Gemuesesaft/freEDrum/Electronics/HeadphoneOut.kicad_sch

## KiCad design Electronics/HeadphoneOut.kicad_sch (2024-04-20)

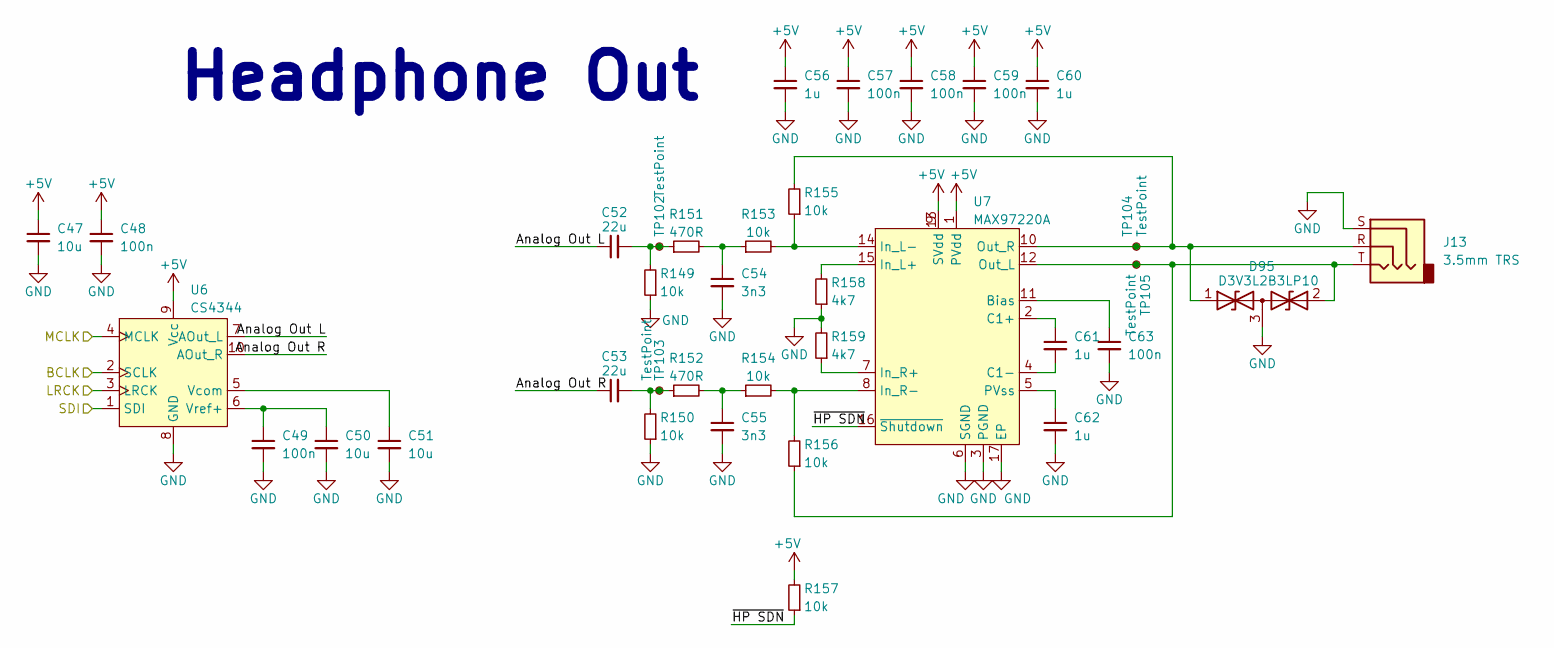
[picture p1: schematic HeadphoneOut.kicad_sch]

Parts:
C47, C50, C51: 10u; C_0805_2012Metric; Rated Voltage 25V; Tolerance 10%; Manufacturer Part # CL21A106KAYNNNE; JLCPCB Part # C15850
C48, C49, C57, C58, C59, C63: 100n; C_0402_1005Metric; Rated Voltage 50V; Tolerance 10%; Manufacturer Part # CL05B104KB54PNC; JLCPCB Part # C307331
C52, C53: 22u; C_1206_3216Metric; Rated Voltage 25V; Tolerance 10%; Manufacturer Part # CL31A226KAHNNNE; JLCPCB Part # C12891
C54, C55: 3n3; C_0603_1608Metric; Rated Voltage 50V; Tolerance 5%; Manufacturer Part # GRM1885C1H332JA01D; JLCPCB Part # C77036
C56, C60, C61, C62: 1u; C_0805_2012Metric; Rated Voltage 50V; Tolerance 10%; Manufacturer Part # CL21B105KBFNNNE; JLCPCB Part # C28323
D95: D3V3L2B3LP10; DFN-3 1010; Manufacturer Part # D3V3L2B3LP10-7; JLCPCB Part # C1974778
J13: 3.5mm TRS; PJ-320B; Manufacturer Part # PJ-320B; JLCPCB Part # C18594
R149, R150, R153, R154, R155, R156, R157: 10k; R_0402_1005Metric; Tolerance 1%; Manufacturer Part # 0402WGF1002TCE; JLCPCB Part # C25744
R151, R152: 470R; R_0402_1005Metric; Tolerance 1%; Manufacturer Part # 0402WGF4700TCE; JLCPCB Part # C25117
R158, R159: 4k7; R_0402_1005Metric; Tolerance 1%; Manufacturer Part # 0402WGF4701TCE; JLCPCB Part # C25900
TP102, TP103, TP104, TP105: TestPoint; TestPoint_Pad_D1.0mm
U6: CS4344; TSSOP-10_3x3mm_P0.5mm; Manufacturer Part # CS4344-CZZR; JLCPCB Part # C8952
U7: MAX97220A; QFN-16-1EP_3x3mm_P0.5mm_EP1.7x1.7mm_ThermalVias; Manufacturer Part # MAX97220AETE+T; JLCPCB Part # C2682711

Connections:
+5V: C47.1, C48.1, C56.1, C57.1, C58.1, C59.1, C60.1, R157.2, U6.9 (Vcc), U7.1 (PVdd), U7.9 (SVdd), U7.13 (SVdd)
Analog Out L: C52.1, U6.7 (AOut_L)
Analog Out R: C53.1, U6.10 (AOut_R)
BCLK: U6.2 (SCLK)
GND: C47.2, C48.2, C49.2, C50.2, C51.2, C54.2, C55.2, C56.2, C57.2, C58.2, C59.2, C60.2, C62.2, C63.2, D95.3 (common), J13.S, R149.1, R150.1, R158.1, R159.2, U6.8 (GND), U7.3 (PGND), U7.6 (SGND), U7.17 (EP)
LRCK: U6.3 (LRCK)
MCLK: U6.4 (MCLK)
unnamed: C49.1, C50.1, U6.6 (Vref+)
unnamed: C51.1, U6.5 (Vcom)
unnamed: C52.2, R149.2, R151.1, TP102.1
unnamed: C53.2, R150.2, R152.1, TP103.1
unnamed: C54.1, R151.2, R153.1
unnamed: C55.1, R152.2, R154.1
unnamed: C61.1, U7.2 (C1+)
unnamed: C61.2, U7.4 (C1-)
unnamed: C62.1, U7.5 (PVss)
unnamed: C63.1, U7.11 (Bias)
unnamed: D95.1 (A1), J13.R, R155.2, TP104.1, U7.10 (Out_R)
unnamed: D95.2 (A2), J13.T, R156.1, TP105.1, U7.12 (Out_L)
unnamed: R153.2, R155.1, U7.14 (In_L-)
unnamed: R154.2, R156.2, U7.8 (In_R-)
unnamed: R158.2, U7.15 (In_L+)
unnamed: R159.1, U7.7 (In_R+)
SDI: U6.1 (SDI)
~HP SDN: R157.1, U7.16 (~Shutdown)

Notes on the sheet:
Headphone Out
