Gemuesesaft/freEDrum/Electronics/Midi.kicad_sch

## KiCad design Electronics/Midi.kicad_sch (2024-04-20)

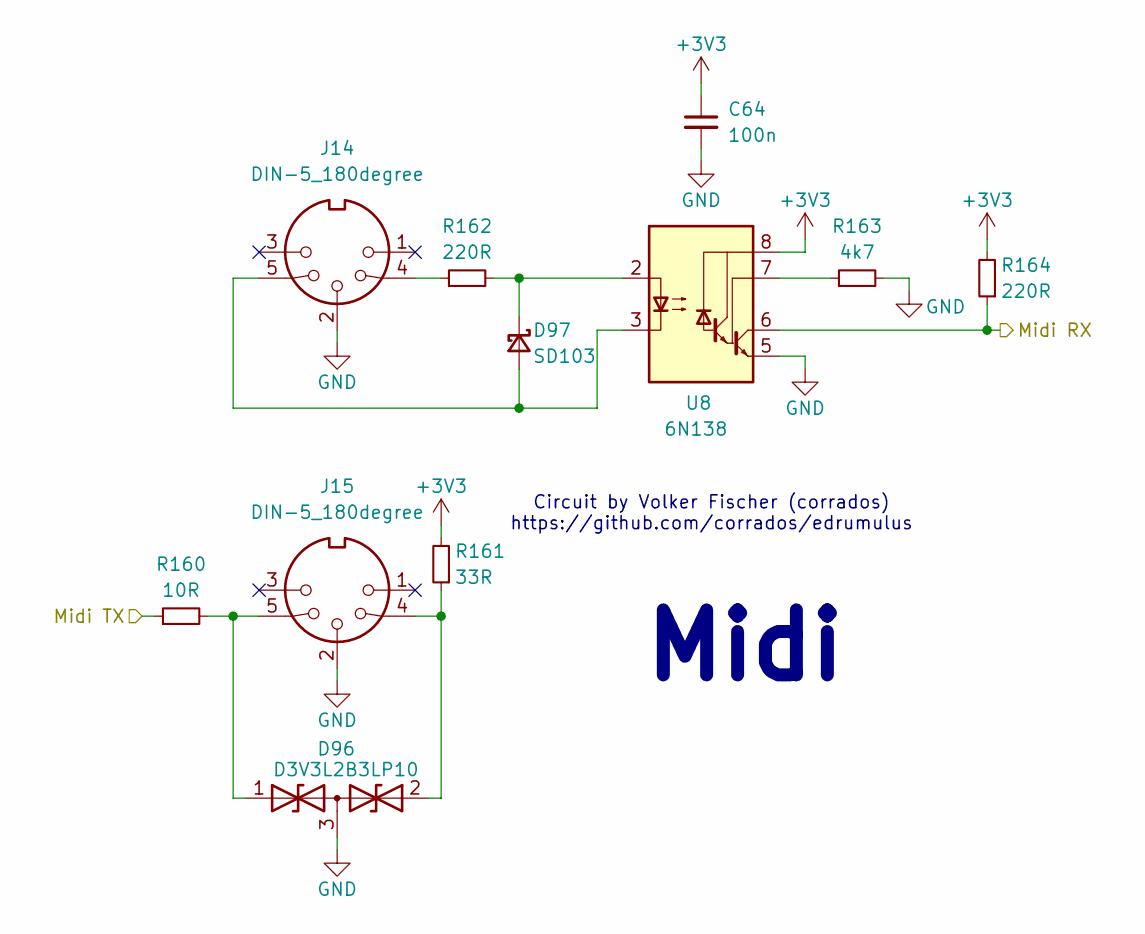
[picture p2: schematic Midi.kicad_sch]

Parts:
C64: 100n; C_0402_1005Metric; Rated Voltage 50V; Tolerance 10%; Manufacturer Part # CL05B104KB54PNC; JLCPCB Part # C307331
D96: D3V3L2B3LP10; DFN-3 1010; Manufacturer Part # D3V3L2B3LP10-7; JLCPCB Part # C1974778
D97: SD103; D_SOD-323; Manufacturer Part # SD103AWS; JLCPCB Part # C7420360
J14, J15: DIN-5_180degree; DIN-504D-M5; Manufacturer Part # DIN-504D-M5; JLCPCB Part # C2939347
R160: 10R; R_0402_1005Metric; Tolerance 1%; Manufacturer Part # 0402WGF100JTCE; JLCPCB Part # C25077
R161: 33R; R_0402_1005Metric; Tolerance 1%; Manufacturer Part # 0402WGF330JTCE; JLCPCB Part # C25105
R162, R164: 220R; R_0402_1005Metric; Tolerance 1%; Manufacturer Part # 0402WGF2200TCE; JLCPCB Part # C25091
R163: 4k7; R_0402_1005Metric; Tolerance 1%; Manufacturer Part # 0402WGF4701TCE; JLCPCB Part # C25900
U8: 6N138; SOP-8_6.605x9.655mm_P2.54mm; Manufacturer Part # 6N138SM; JLCPCB Part # C255744

Connections:
+3V3: C64.1, R161.2, R164.2, U8.8 (VCC)
GND: C64.2, D96.3 (common), J14.2, J15.2, R163.2, U8.5 (GND)
Midi RX: R164.1, U8.6 (VO2)
Midi TX: R160.1
unnamed: D96.1 (A1), J15.5, R160.2
unnamed: D96.2 (A2), J15.4, R161.1
unnamed: D97.1 (K), R162.2, U8.2 (C1)
unnamed: D97.2 (A), J14.5, U8.3 (C2)
unnamed: J14.4, R162.1
unnamed: R163.1, U8.7 (VO1)

Notes on the sheet:
Midi
Circuit by Volker Fischer (corrados) https://github.com/corrados/edrumulus
