Gemuesesaft/freEDrum/Electronics/PedalInput.kicad_sch

## KiCad design Electronics/PedalInput.kicad_sch (2024-04-20)

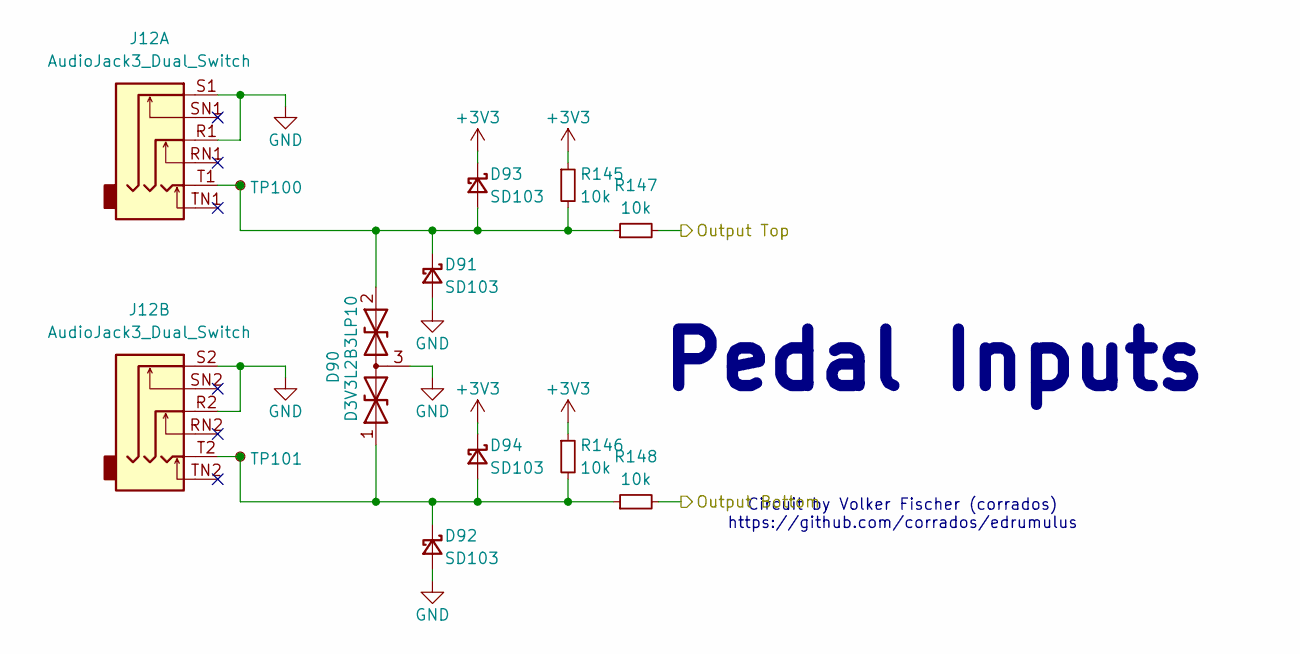
[picture p3: schematic PedalInput.kicad_sch]

Parts:
D90: D3V3L2B3LP10; DFN-3 1010; Manufacturer Part # D3V3L2B3LP10-7; JLCPCB Part # C1974778
D91, D92, D93, D94: SD103; D_SOD-323; Manufacturer Part # SD103AWS; JLCPCB Part # C7420360
J12: AudioJack3_Dual_Switch; PJ-625DK; Manufacturer Part # PJ-625DK; JLCPCB Part # C309295
R145, R146, R147, R148: 10k; R_0402_1005Metric; Tolerance 1%; Manufacturer Part # 0402WGF1002TCE; JLCPCB Part # C25744
TP100, TP101: TestPoint; TestPoint_Pad_D1.0mm

Connections:
+3V3: D93.1 (K), D94.1 (K), R145.1, R146.1
GND: D90.3 (common), D91.2 (A), D92.2 (A), J12.R1, J12.R2, J12.S1, J12.S2
unnamed: D90.1 (A1), D92.1 (K), D94.2 (A), J12.T2, R146.2, R148.1, TP101.1
unnamed: D90.2 (A2), D91.1 (K), D93.2 (A), J12.T1, R145.2, R147.1, TP100.1
Output Bottom: R148.2
Output Top: R147.2

Notes on the sheet:
Pedal Inputs
Circuit by Volker Fischer (corrados) https://github.com/corrados/edrumulus
