Gemuesesaft/freEDrum/Electronics/RS485Transceiver.kicad_sch

## KiCad design Electronics/RS485Transceiver.kicad_sch (2024-04-20)

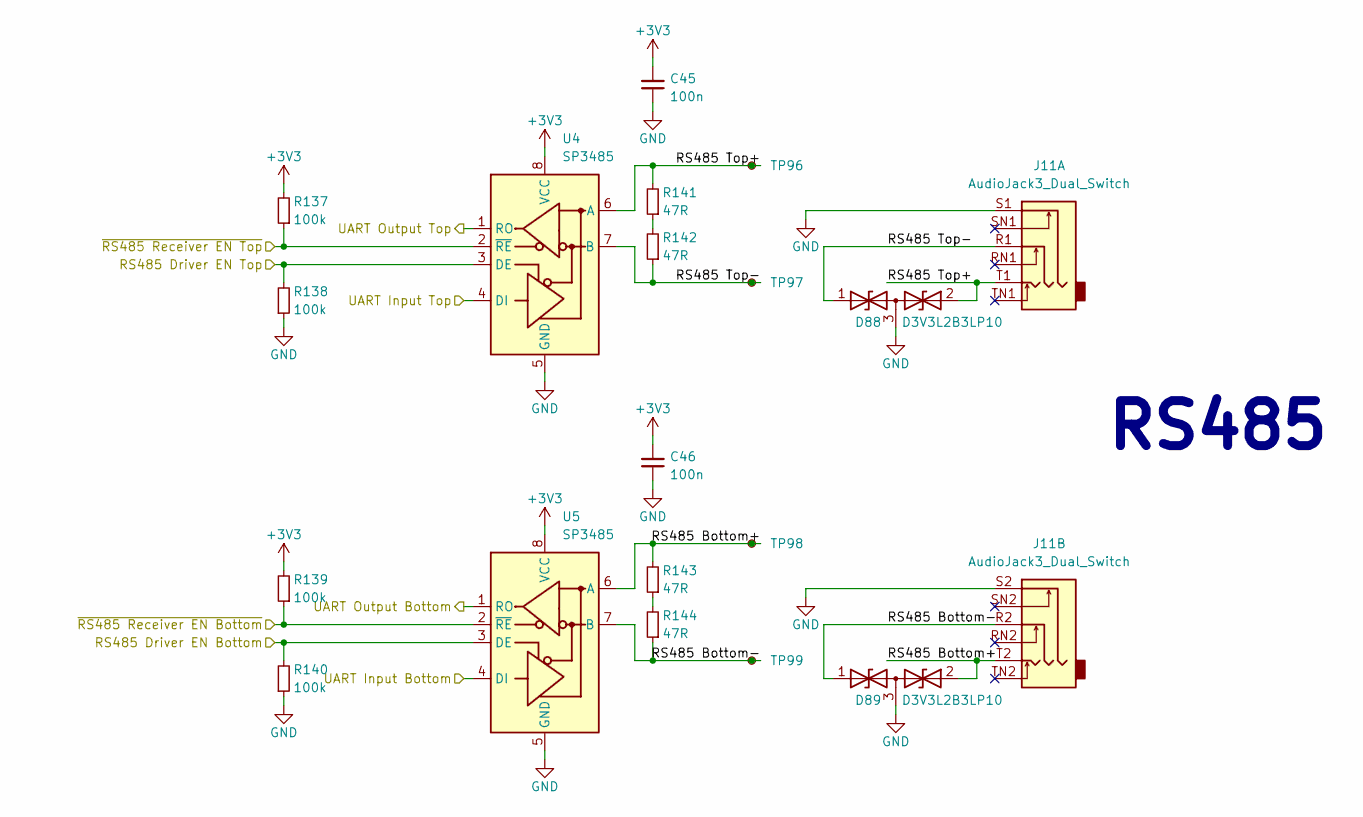
[picture p4: schematic RS485Transceiver.kicad_sch]

Parts:
C45, C46: 100n; C_0402_1005Metric; Rated Voltage 50V; Tolerance 10%; Manufacturer Part # CL05B104KB54PNC; JLCPCB Part # C307331
D88, D89: D3V3L2B3LP10; DFN-3 1010; Manufacturer Part # D3V3L2B3LP10-7; JLCPCB Part # C1974778
J11: AudioJack3_Dual_Switch; PJ-625DK; Manufacturer Part # PJ-625DK; JLCPCB Part # C309295
R137, R138, R139, R140: 100k; R_0402_1005Metric; Tolerance 1%; Manufacturer Part # 0402WGF1003TCE; JLCPCB Part # C25741
R141, R142, R143, R144: 47R; R_0805_2012Metric; Tolerance 1%; Manufacturer Part # 0805W8F470JT5E; JLCPCB Part # C17714
TP96, TP97, TP98, TP99: TestPoint; TestPoint_Pad_D1.0mm
U4, U5: SP3485; SOIC-8_3.9x4.9mm_P1.27mm; Manufacturer Part # SP3485EN-L/TR; JLCPCB Part # C8963

Connections:
+3V3: C45.2, C46.2, R137.2, R139.2, U4.8 (VCC), U5.8 (VCC)
GND: C45.1, C46.1, D88.3 (common), D89.3 (common), J11.S1, J11.S2, R138.1, R140.1, U4.5 (GND), U5.5 (GND)
unnamed: R141.1, R142.2
unnamed: R143.1, R144.2
RS485 Bottom+: D89.2 (A2), J11.T2, R143.2, TP98.1, U5.6 (A)
RS485 Bottom-: D89.1 (A1), J11.R2, R144.1, TP99.1, U5.7 (B)
RS485 Driver EN Bottom: R140.2, U5.3 (DE)
RS485 Driver EN Top: R138.2, U4.3 (DE)
RS485 Top+: D88.2 (A2), J11.T1, R141.2, TP96.1, U4.6 (A)
RS485 Top-: D88.1 (A1), J11.R1, R142.1, TP97.1, U4.7 (B)
UART Input Bottom: U5.4 (DI)
UART Input Top: U4.4 (DI)
UART Output Bottom: U5.1 (RO)
UART Output Top: U4.1 (RO)
~RS485 Receiver EN Bottom: R139.1, U5.2 (~RE)
~RS485 Receiver EN Top: R137.1, U4.2 (~RE)

Notes on the sheet:
RS485
