Gemuesesaft/freEDrum/Electronics/TriggerInput.kicad_sch

## KiCad design Electronics/TriggerInput.kicad_sch (2024-04-20)

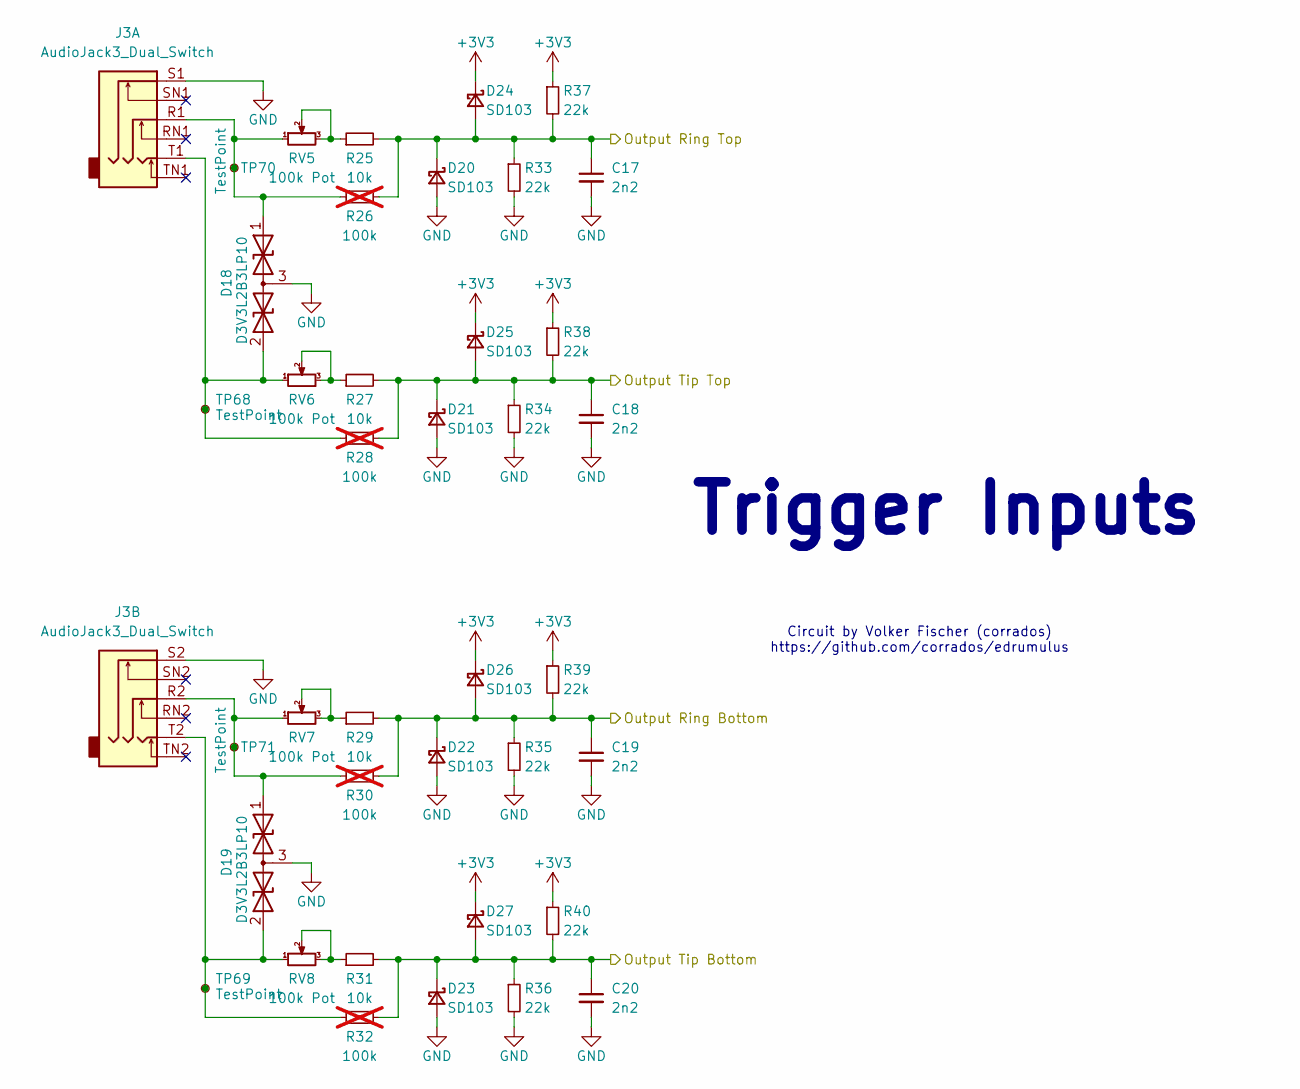
[picture p5: schematic TriggerInput.kicad_sch]

Parts:
C17, C18, C19, C20: 2n2; C_0603_1608Metric; Rated Voltage 50V; Tolerance 10%; Manufacturer Part # 0603B222K500NT; JLCPCB Part # C1604
D18, D19: D3V3L2B3LP10; DFN-3 1010; Manufacturer Part # D3V3L2B3LP10-7; JLCPCB Part # C1974778
D20, D21, D22, D23, D24, D25, D26, D27: SD103; D_SOD-323; Manufacturer Part # SD103AWS; JLCPCB Part # C7420360
J3: AudioJack3_Dual_Switch; PJ-625DK; Manufacturer Part # PJ-625DK; JLCPCB Part # C309295
R25, R27, R29, R31: 10k; R_0402_1005Metric; Tolerance 1%; Manufacturer Part # 0402WGF1002TCE; JLCPCB Part # C25744
R26, R28, R30, R32: 100k; R_0402_1005Metric; Tolerance 1%; Manufacturer Part # 0402WGF1003TCE; JLCPCB Part # C25741; not fitted
R33, R34, R35, R36, R37, R38, R39, R40: 22k; R_0402_1005Metric; Tolerance 1%; Manufacturer Part # 0402WGF2202TCE; JLCPCB Part # C25768
RV5, RV6, RV7, RV8: 100k Pot; Potentiometer_Bourns_TC33X_Vertical; Tolerance 20%; Manufacturer Part # VG039NCHXTB104; JLCPCB Part # C128545
TP68, TP69, TP70, TP71: TestPoint; TestPoint_Pad_D1.0mm

Connections:
+3V3: D24.1 (K), D25.1 (K), D26.1 (K), D27.1 (K), R37.1, R38.1, R39.1, R40.1
GND: C17.2, C18.2, C19.2, C20.2, D18.3 (common), D19.3 (common), D20.2 (A), D21.2 (A), D22.2 (A), D23.2 (A), J3.S1, J3.S2, R33.2, R34.2, R35.2, R36.2
unnamed: D18.1 (A1), J3.R1, R26.1, RV5.1, TP70.1
unnamed: D18.2 (A2), J3.T1, R28.1, RV6.1, TP68.1
unnamed: D19.1 (A1), J3.R2, R30.1, RV7.1, TP71.1
unnamed: D19.2 (A2), J3.T2, R32.1, RV8.1, TP69.1
unnamed: R25.1, RV5.2, RV5.3
unnamed: R27.1, RV6.2, RV6.3
unnamed: R29.1, RV7.2, RV7.3
unnamed: R31.1, RV8.2, RV8.3
Output Ring Bottom: C19.1, D22.1 (K), D26.2 (A), R29.2, R30.2, R35.1, R39.2
Output Ring Top: C17.1, D20.1 (K), D24.2 (A), R25.2, R26.2, R33.1, R37.2
Output Tip Bottom: C20.1, D23.1 (K), D27.2 (A), R31.2, R32.2, R36.1, R40.2
Output Tip Top: C18.1, D21.1 (K), D25.2 (A), R27.2, R28.2, R34.1, R38.2

Notes on the sheet:
Trigger Inputs
Circuit by Volker Fischer (corrados) https://github.com/corrados/edrumulus
