Gemuesesaft/freEDrum/Electronics/freEDrum.kicad_sch

## KiCad design Electronics/freEDrum.kicad_sch (2024-04-20)

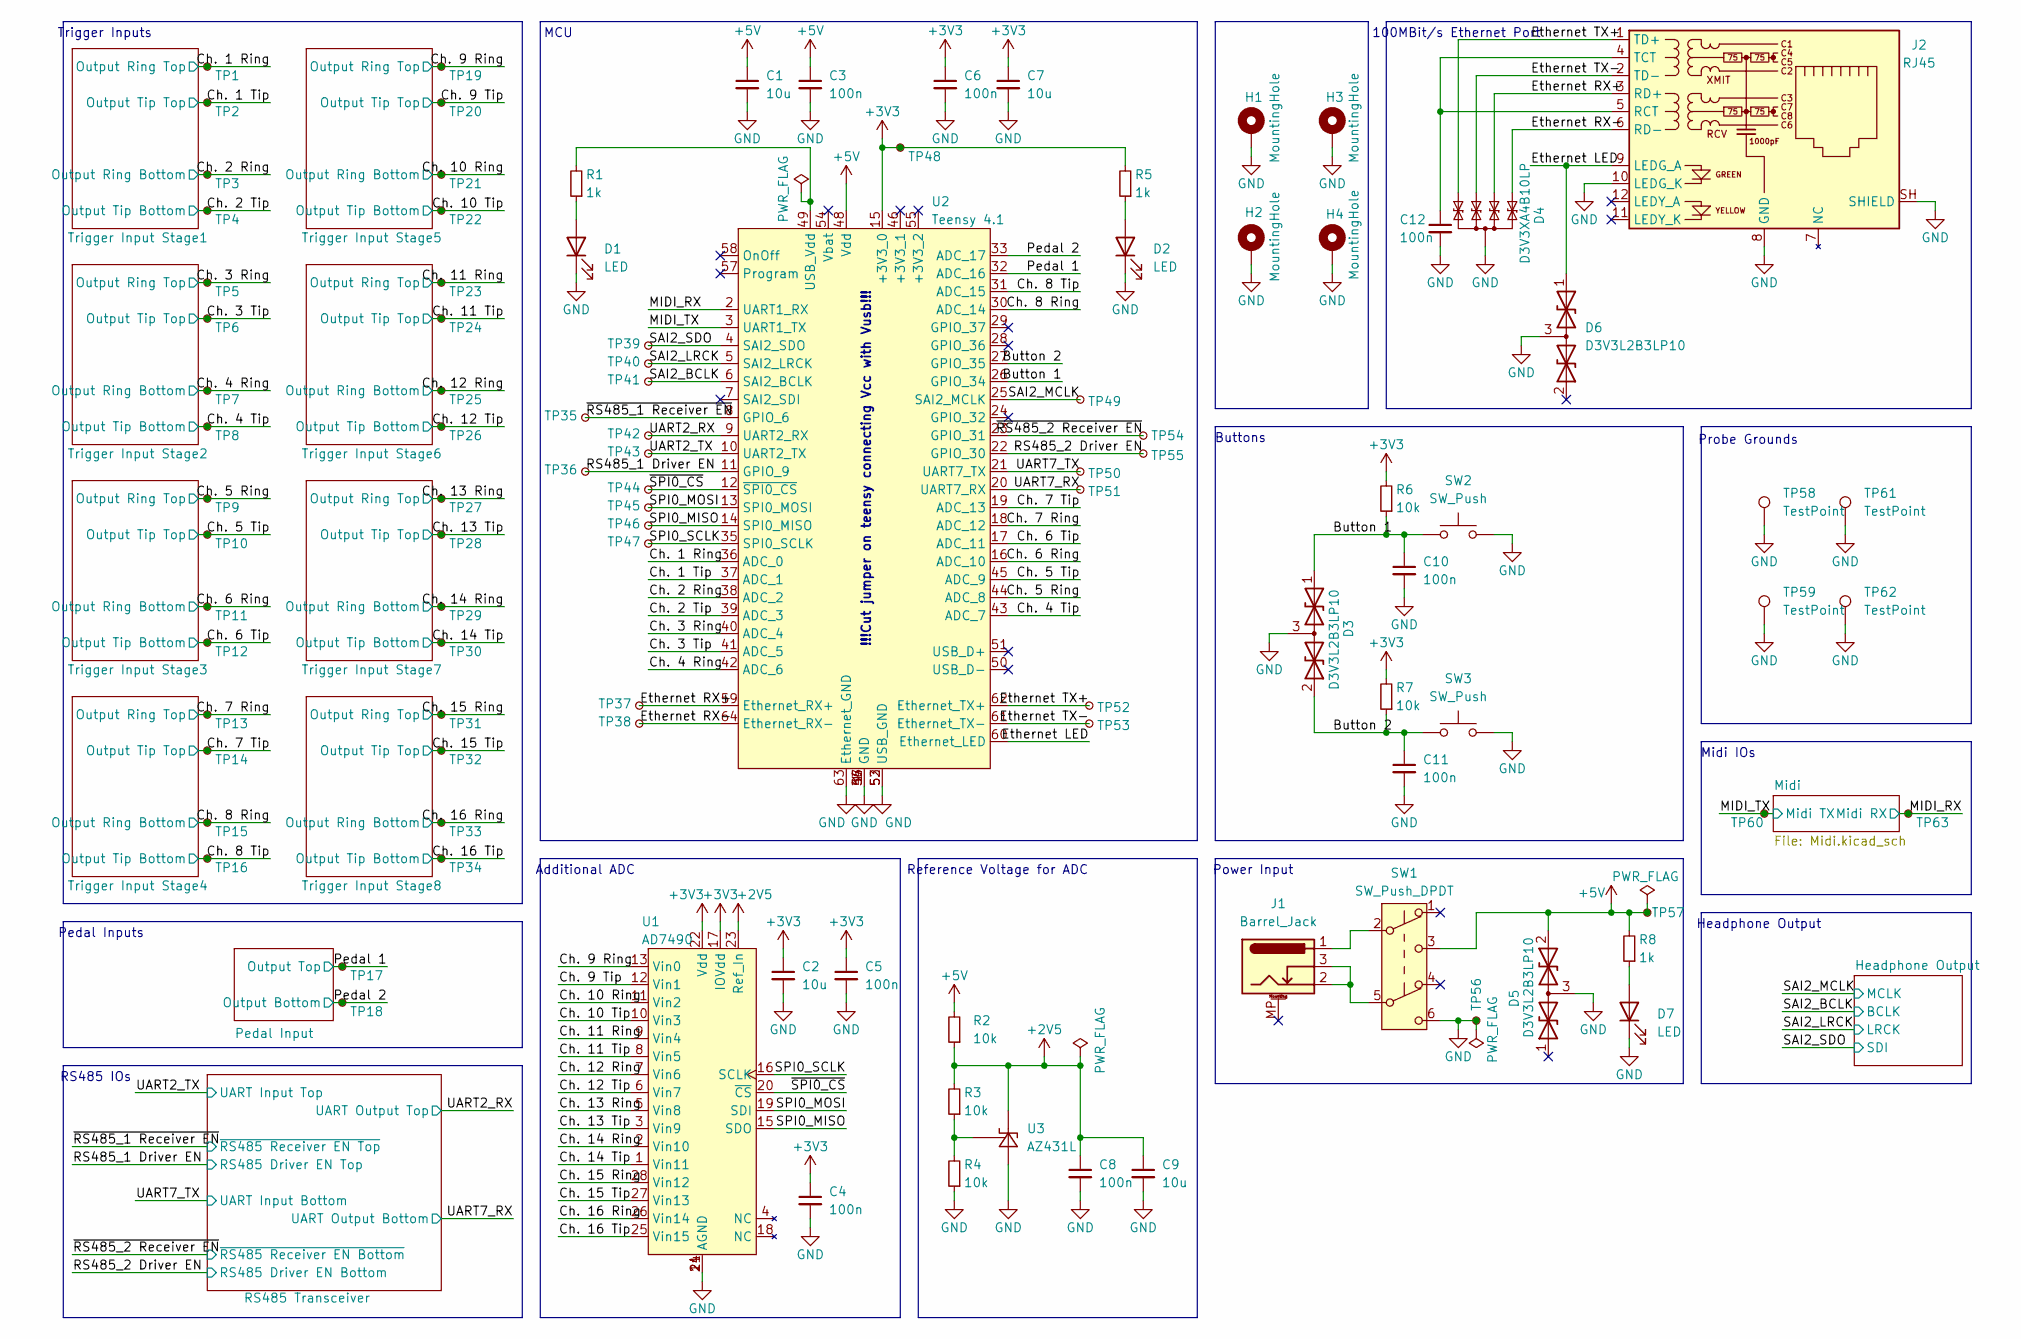
[picture p6: schematic freEDrum.kicad_sch]

Parts:
C1, C2, C7, C9: 10u; C_0805_2012Metric; Rated Voltage 25V; Tolerance 10%; Manufacturer Part # CL21A106KAYNNNE; JLCPCB Part # C15850
C3, C4, C5, C6, C8, C10, C11, C12: 100n; C_0402_1005Metric; Rated Voltage 50V; Tolerance 10%; Manufacturer Part # CL05B104KB54PNC; JLCPCB Part # C307331
D1, D2, D7: LED; LED_0805_2012Metric; Manufacturer Part # KT-0805G; JLCPCB Part # C2297
D3, D5, D6: D3V3L2B3LP10; DFN-3 1010; Manufacturer Part # D3V3L2B3LP10-7; JLCPCB Part # C1974778
D4: D3V3XA4B10LP; Diodes_UDFN-10_1.0x2.5mm_P0.5mm; Manufacturer Part # D3V3XA4B10LP-7; JLCPCB Part # C1980462
H1, H2, H3, H4: MountingHole; MountingHole_3.2mm_M3_Pad_Via
J1: Barrel_Jack; DC050-T; Manufacturer Part # DC050-T; JLCPCB Part # C431534
J2: RJ45; RJ45_Hanrun_HR911105A_Horizontal; Manufacturer Part # HY911105AE; JLCPCB Part # C69427
R1, R5, R8: 1k; R_0402_1005Metric; Tolerance 1%; Manufacturer Part # 0402WGF1001TCE; JLCPCB Part # C11702
R2, R3, R4, R6, R7: 10k; R_0402_1005Metric; Tolerance 1%; Manufacturer Part # 0402WGF1002TCE; JLCPCB Part # C25744
SW1: SW_Push_DPDT; PS-5850A-6P; Manufacturer Part # PS-5850A-6PL; JLCPCB Part # C963201
SW2, SW3: SW_Push; SKMP; Manufacturer Part # SKPMBHE010; JLCPCB Part # C115350
TP1, TP2, TP3, TP4, TP5, TP6, TP7, TP8, TP9, TP10, TP11, TP12, TP13, TP14, TP15, TP16, TP17, TP18, TP19, TP20, TP21, TP22, TP23, TP24, TP25, TP26, TP27, TP28, TP29, TP30, TP31, TP32, TP33, TP34, TP35, TP36, TP37, TP38, TP39, TP40, TP41, TP42, TP43, TP44, TP45, TP46, TP47, TP48, TP49, TP50, TP51, TP52, TP53, TP54, TP55, TP56, TP57, TP60, TP63: TestPoint; TestPoint_Pad_D1.0mm
TP58, TP59, TP61, TP62: TestPoint; TestPoint_Keystone_5019_Minature
U1: AD7490; TSSOP-28_4.4x9.7mm_P0.65mm; Manufacturer Part # AD7490BRUZ-REEL7; JLCPCB Part # C36884
U2: Teensy 4.1; Manufacturer Part # Teensy 4.1
U3: AZ431L; SOT-23; Manufacturer Part # AZ431LANTR-E1; JLCPCB Part # C115253

Connections:
+2V5: C8.1, C9.1, R2.1, R3.2, U1.23 (Ref_In), U3.2 (K)
+3V3: C2.1, C4.1, C5.1, C6.1, C7.1, R5.2, R6.2, R7.2, TP48.1, U1.17 (IOVdd), U1.22 (Vdd), U2.15 (+3V3_0)
+5V: C1.1, C3.1, D5.2 (A2), R2.2, R8.2, SW1.3 (C), TP57.1, U2.48 (Vdd)
Button 1: C10.1, D3.1 (A1), R6.1, SW2.1, U2.26 (GPIO_34)
Button 2: C11.1, D3.2 (A2), R7.1, SW3.1, U2.27 (GPIO_35)
Ch. 1 Ring: TP1.1, U2.36 (GPIO_14)
Ch. 1 Tip: TP2.1, U2.37 (GPIO_15)
Ch. 2 Ring: TP3.1, U2.38 (GPIO_16)
Ch. 2 Tip: TP4.1, U2.39 (GPIO_17)
Ch. 3 Ring: TP5.1, U2.40 (GPIO_18)
Ch. 3 Tip: TP6.1, U2.41 (GPIO_19)
Ch. 4 Ring: TP7.1, U2.42 (GPIO_20)
Ch. 4 Tip: TP8.1, U2.43 (GPIO_21)
Ch. 5 Ring: TP9.1, U2.44 (GPIO_22)
Ch. 5 Tip: TP10.1, U2.45 (GPIO_23)
Ch. 6 Ring: TP11.1, U2.16 (GPIO_24)
Ch. 6 Tip: TP12.1, U2.17 (GPIO_25)
Ch. 7 Ring: TP13.1, U2.18 (GPIO_26)
Ch. 7 Tip: TP14.1, U2.19 (GPIO_27)
Ch. 8 Ring: TP15.1, U2.30 (GPIO_38)
Ch. 8 Tip: TP16.1, U2.31 (GPIO_39)
Ch. 9 Ring: TP19.1, U1.13 (Vin0)
Ch. 9 Tip: TP20.1, U1.12 (Vin1)
Ch. 10 Ring: TP21.1, U1.11 (Vin2)
Ch. 10 Tip: TP22.1, U1.10 (Vin3)
Ch. 11 Ring: TP23.1, U1.9 (Vin4)
Ch. 11 Tip: TP24.1, U1.8 (Vin5)
Ch. 12 Ring: TP25.1, U1.7 (Vin6)
Ch. 12 Tip: TP26.1, U1.6 (Vin7)
Ch. 13 Ring: TP27.1, U1.5 (Vin8)
Ch. 13 Tip: TP28.1, U1.3 (Vin9)
Ch. 14 Ring: TP29.1, U1.2 (Vin10)
Ch. 14 Tip: TP30.1, U1.1 (Vin11)
Ch. 15 Ring: TP31.1, U1.28 (Vin12)
Ch. 15 Tip: TP32.1, U1.27 (Vin13)
Ch. 16 Ring: TP33.1, U1.26 (Vin14)
Ch. 16 Tip: TP34.1, U1.25 (Vin15)
Ethernet LED: D6.1 (A1), J2.9 (LEDG_A), U2.60 (Ethernet_LED)
Ethernet RX+: D4.4 (A3), J2.3 (RD+), TP37.1, U2.59 (Ethernet_RX+)
Ethernet RX-: D4.5 (A4), J2.6 (RD-), TP38.1, U2.64 (Ethernet_RX-)
Ethernet TX+: D4.1 (A1), J2.1 (TD+), TP52.1, U2.62 (Ethernet_TX+)
Ethernet TX-: D4.2 (A3), J2.2 (TD-), TP53.1, U2.61 (Ethernet_TX-)
GND: C1.2, C2.2, C3.2, C4.2, C5.2, C6.2, C7.2, C8.2, C9.2, C10.2, C11.2, C12.2, D1.1 (K), D2.1 (K), D3.3 (common), D4.3 (CA), D4.8 (CA), D5.3 (common), D6.3 (common), D7.1 (K), H1.1, H2.1, H3.1, H4.1, J2.8 (GND), J2.10 (LEDG_K), J2.SH (SHIELD), R4.1, SW1.6 (C), SW2.2, SW3.2, TP56.1, TP58.1, TP59.1, TP61.1, TP62.1, U1.14 (AGND), U1.21 (AGND), U1.24 (AGND), U2.1 (GND), U2.34 (GND), U2.47 (GND), U2.52 (USB_GND), U2.53 (USB_GND), U2.56 (GND), U2.63 (Ethernet_GND), U3.3 (A)
MIDI_RX: TP63.1, U2.2 (GPIO_0)
MIDI_TX: TP60.1, U2.3 (GPIO_1)
unnamed: C12.1, J2.4 (TCT), J2.5 (RCT)
unnamed: D1.2 (A), R1.1
unnamed: D2.2 (A), R5.1
unnamed: D7.2 (A), R8.1
unnamed: J1.1, SW1.2 (B)
unnamed: J1.2, J1.3, SW1.5 (B)
unnamed: R1.2, U2.49 (USB_Vdd)
unnamed: R3.1, R4.2, U3.1 (FB)
Pedal 1: TP17.1, U2.32 (GPIO_40)
Pedal 2: TP18.1, U2.33 (GPIO_41)
RS485_1 Driver EN: TP36.1, U2.11 (GPIO_9)
RS485_2 Driver EN: TP55.1, U2.22 (GPIO_30)
SAI2_BCLK: TP41.1, U2.6 (GPIO_4)
SAI2_LRCK: TP40.1, U2.5 (GPIO_3)
SAI2_MCLK: TP49.1, U2.25 (GPIO_33)
SAI2_SDO: TP39.1, U2.4 (GPIO_2)
SPI0_MISO: TP46.1, U1.15 (SDO), U2.14 (GPIO_12)
SPI0_MOSI: TP45.1, U1.19 (SDI), U2.13 (GPIO_11)
SPI0_SCLK: TP47.1, U1.16 (SCLK), U2.35 (GPIO_13)
UART2_RX: TP42.1, U2.9 (GPIO_7)
UART2_TX: TP43.1, U2.10 (GPIO_8)
UART7_RX: TP51.1, U2.20 (GPIO_28)
UART7_TX: TP50.1, U2.21 (GPIO_29)
~RS485_1 Receiver EN: TP35.1, U2.8 (GPIO_6)
~RS485_2 Receiver EN: TP54.1, U2.23 (GPIO_31)
~SPI0_CS: TP44.1, U1.20 (~CS), U2.12 (GPIO_10)

Notes on the sheet:
!!!Cut jumper on teensy connecting Vcc with Vusb!!!
Headphone Output
Trigger Inputs
100MBit/s Ethernet Port
Pedal Inputs
MCU
Midi IOs
Additional ADC
RS485 IOs
Buttons
Reference Voltage for ADC
Probe Grounds
Power Input
