Gemuesesaft/freEDrum/(commit log)

2024-04-20 Initial commit.
    [HeadphoneOut.kicad_sch, Midi.kicad_sch, PedalInput.kicad_sch, RS485Transceiver.kicad_sch, TriggerInput.kicad_sch, bom.csv, designators.csv, freEDrum.kicad_sch]
2024-04-20 Adds PDF schematic and folder for firmware
    [HeadphoneOut.kicad_sch, Midi.kicad_sch, PedalInput.kicad_sch, RS485Transceiver.kicad_sch, TriggerInput.kicad_sch, freEDrum.kicad_sch]
